Jdbailey7/NSSL_EFM_Rotating_PCB/Renders/pcb_back.png

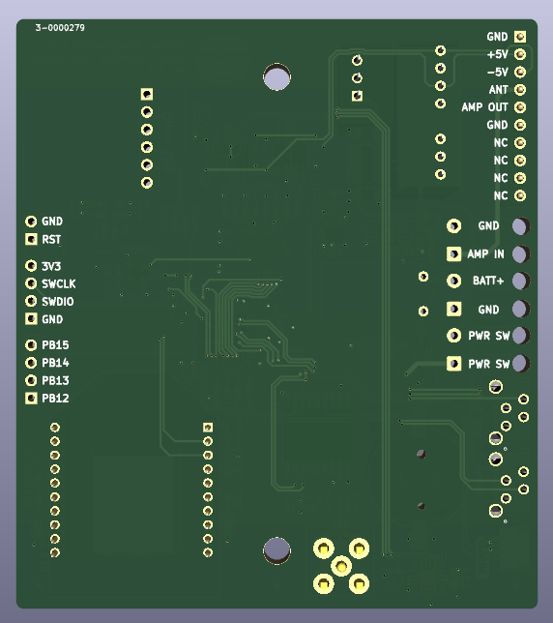
Renders/pcb_back.png
