Jdbailey7/NSSL_EFM_Rotating_PCB/Renders/pcb_front.png

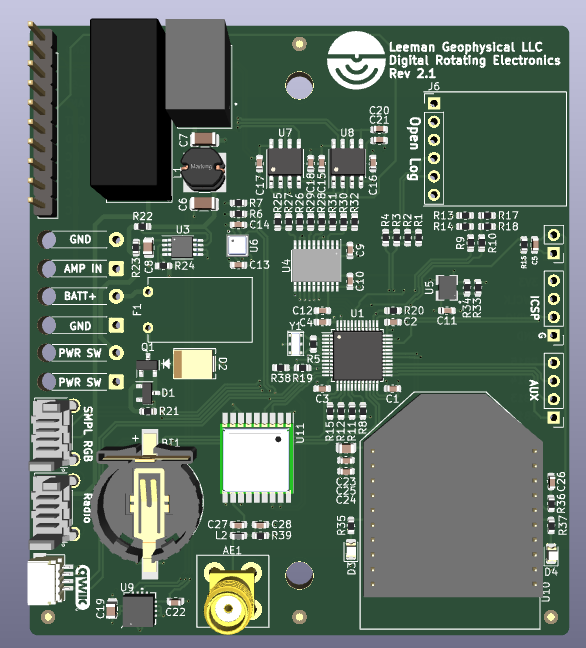
Renders/pcb_front.png
