Jdbailey7/NSSL_EFM_Rotating_PCB/PDFs/schematic.pdf

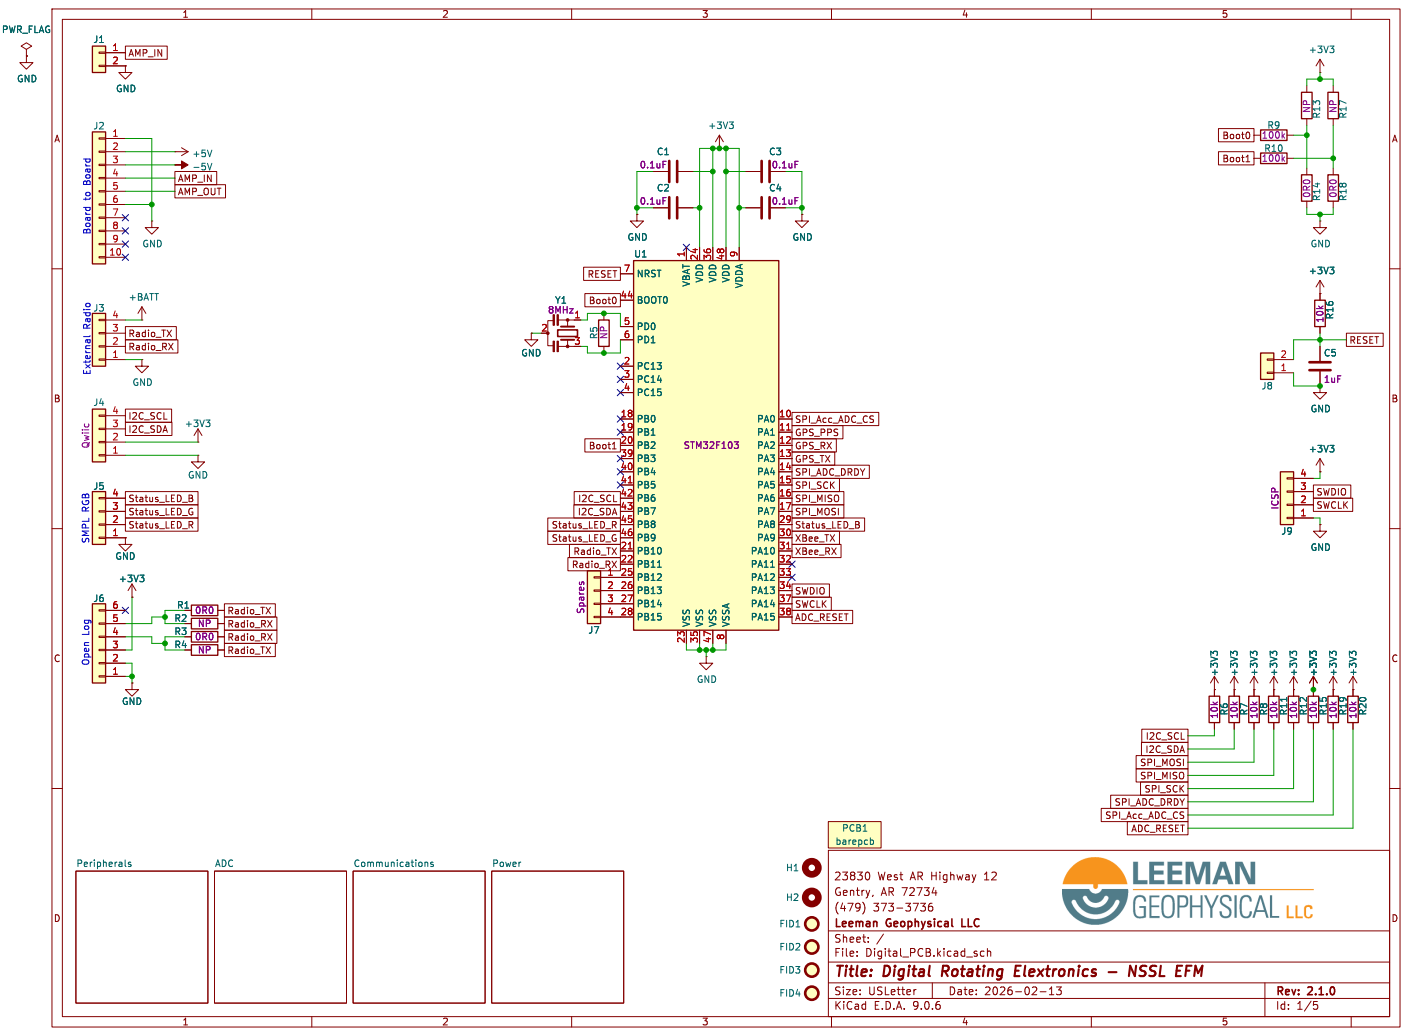
[picture p3: page 1]

1 VSS 23 VDD 24 VSS 35 VDD 36 VSS 47 VDD 48 VSSA

Id: 1/5 Title: Digital Rotating Elextronics - NSSL EFM

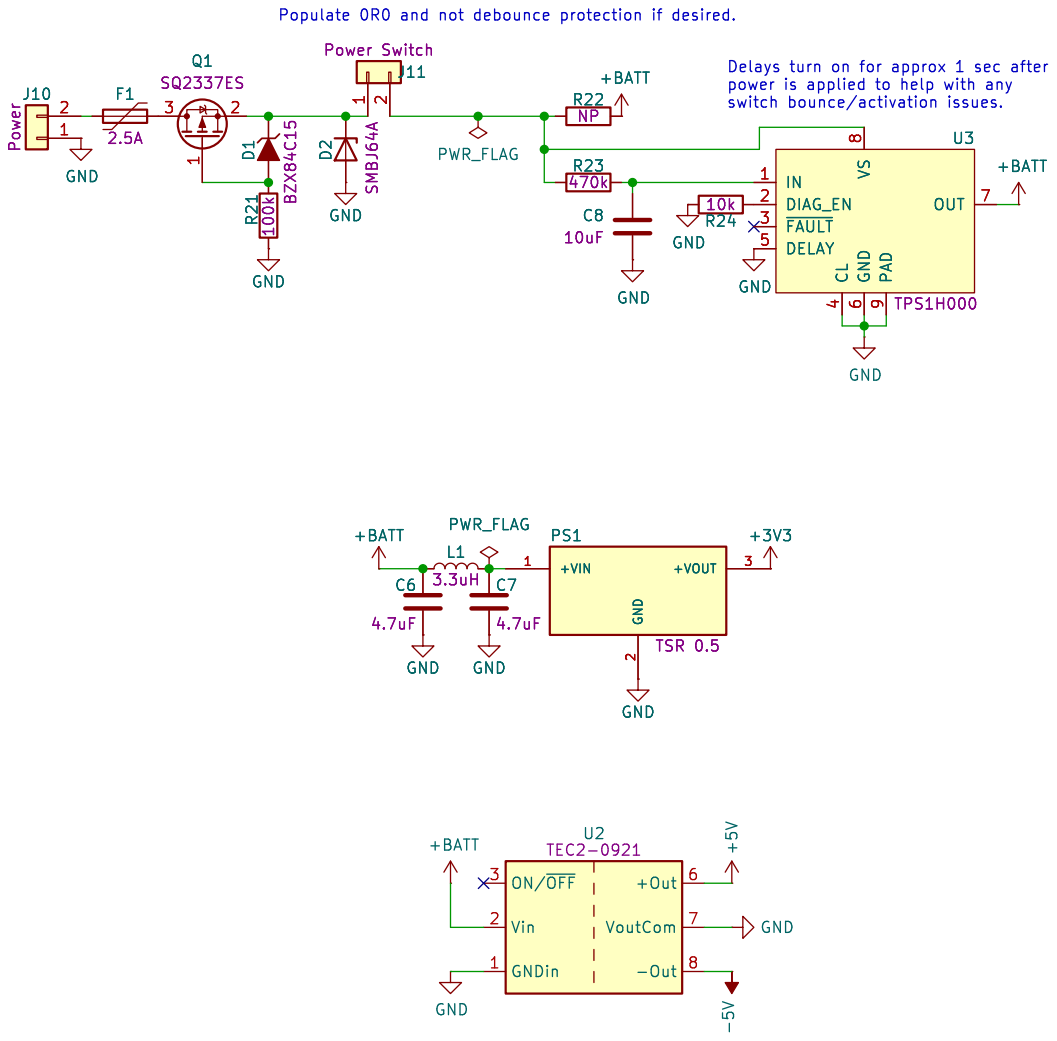
[picture p4: page 2]

9 OUT 7 U3 TPS1H000 Delays turn on for approx 1 sec after power is applied to help with any

2 +VIN 1 +VOUT 3 PS1 TSR 0.5 GND

9 OUT 7 +BATT GND GND

Id: 2/5 Title: Digital Rotating Elextronics - NSSL EFM

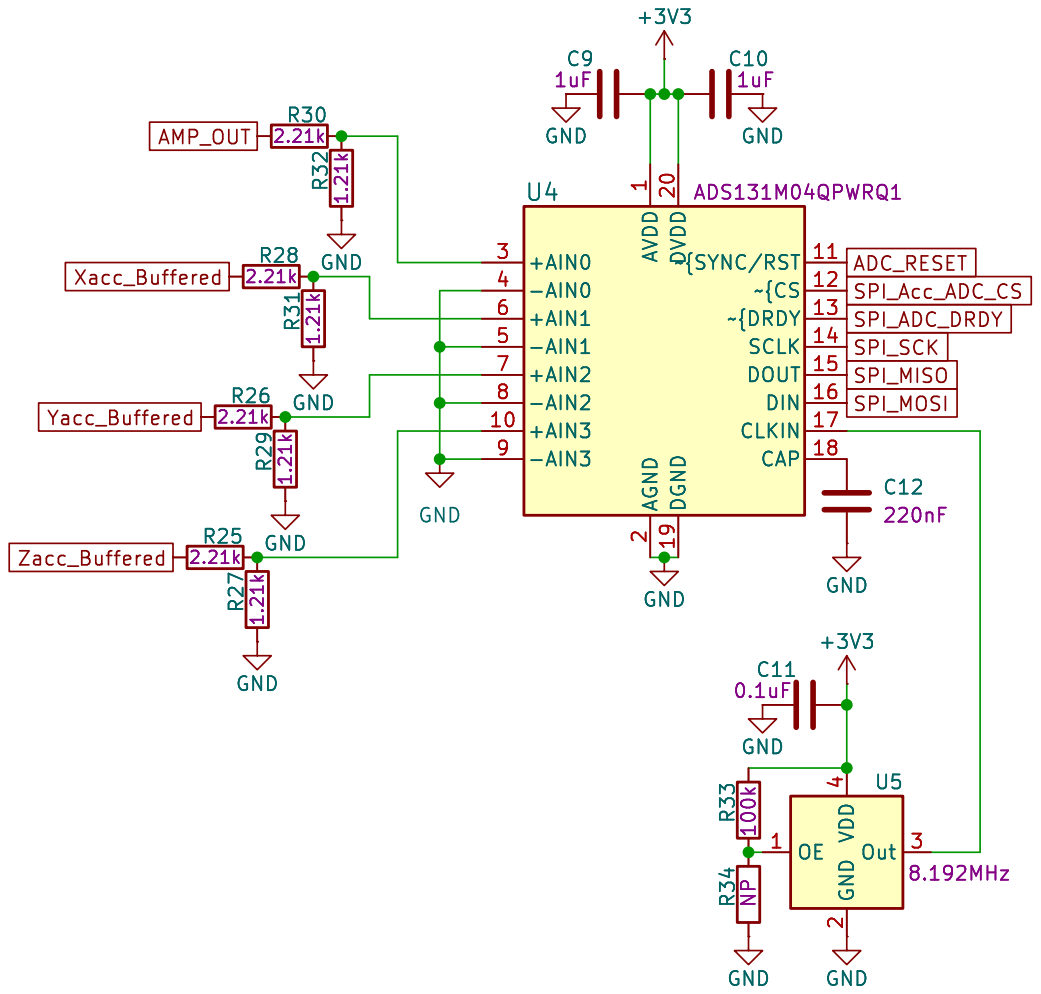
[picture p5: page 3]

Id: 3/5 Title: Digital Rotating Elextronics - NSSL EFM

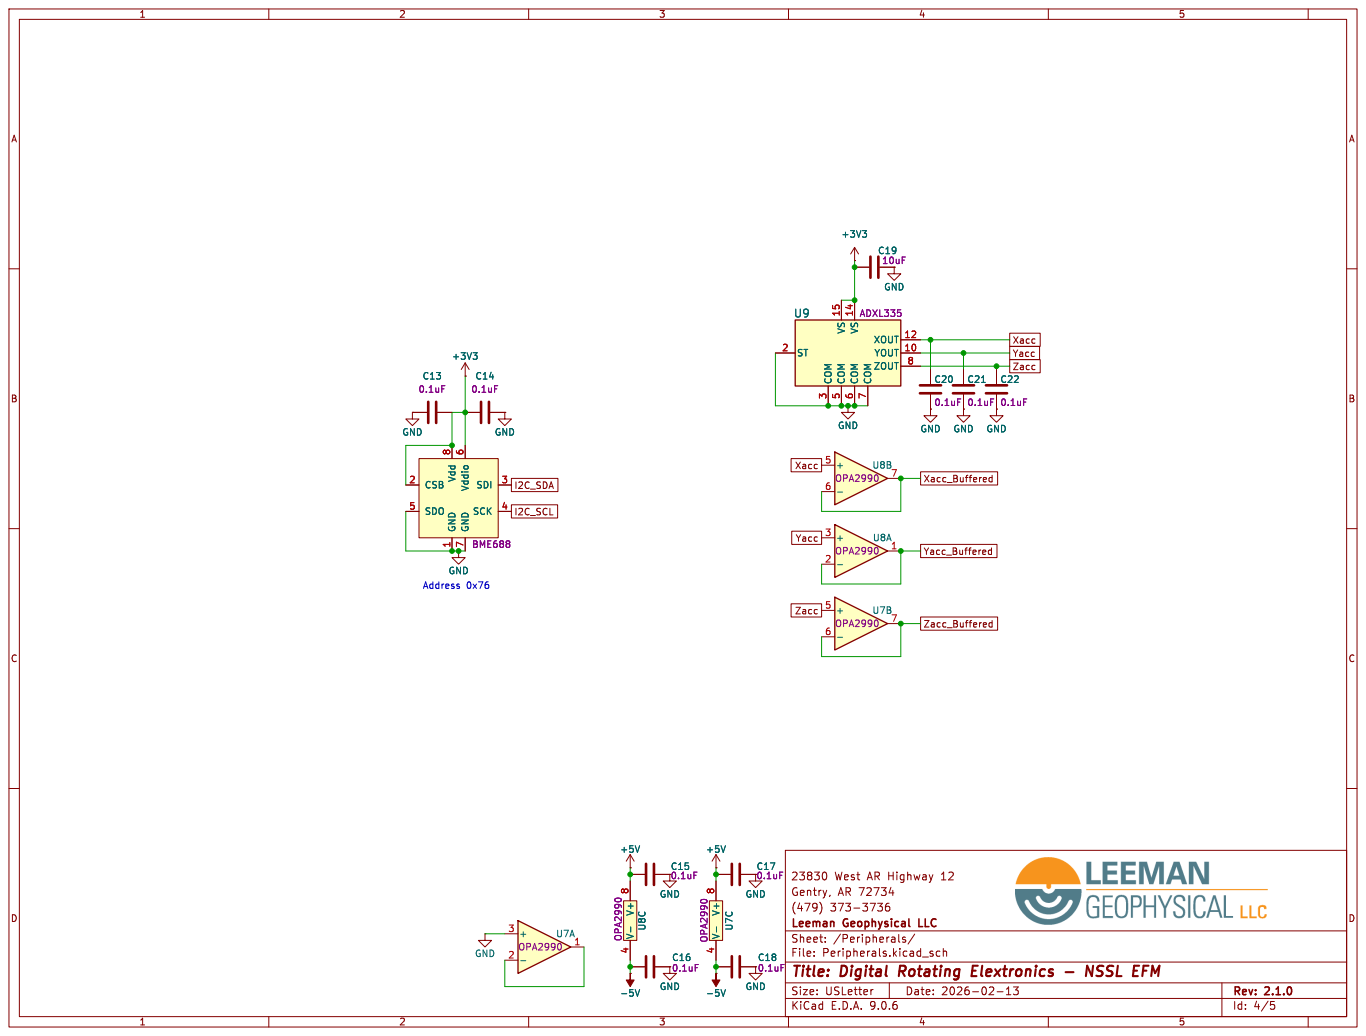
[picture p6: page 4]

(479) 373-3736 Gentry, AR 72734

E.D.A. 9.0.6 Size: USLetter | Rev: 2.1.0 | D Date: 2026-02-13 KiCad

Id: 4/5 Title: Digital Rotating Elextronics - NSSL EFM

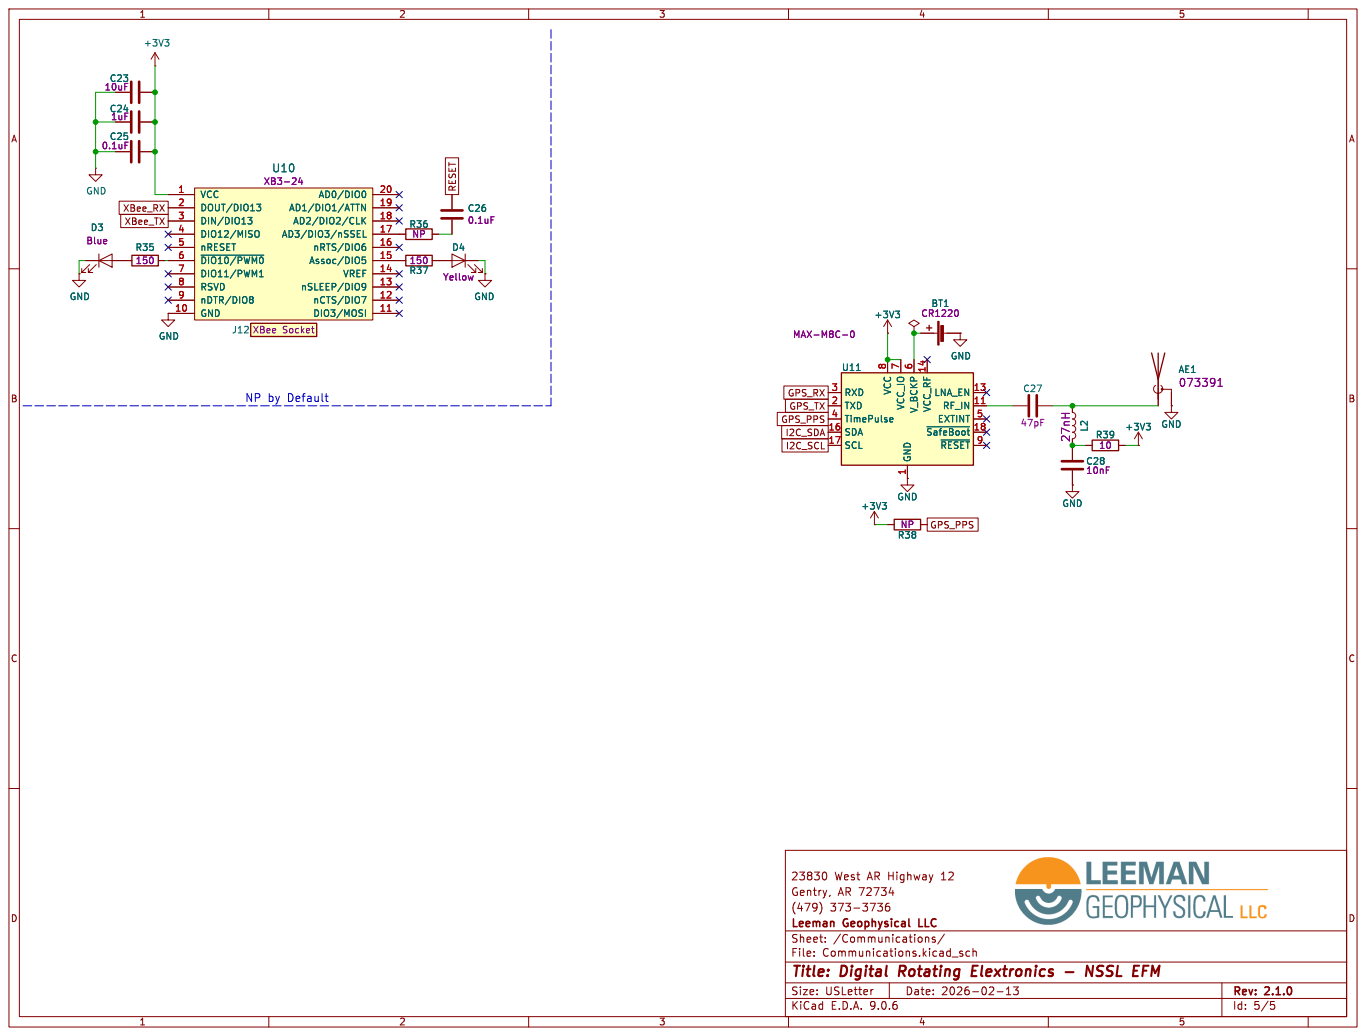
[picture p7: page 5]

Id: 5/5 Title: Digital Rotating Elextronics - NSSL EFM
