Jdbailey7/NSSL_EFM_Rotating_PCB/PDFs/pcb.pdf

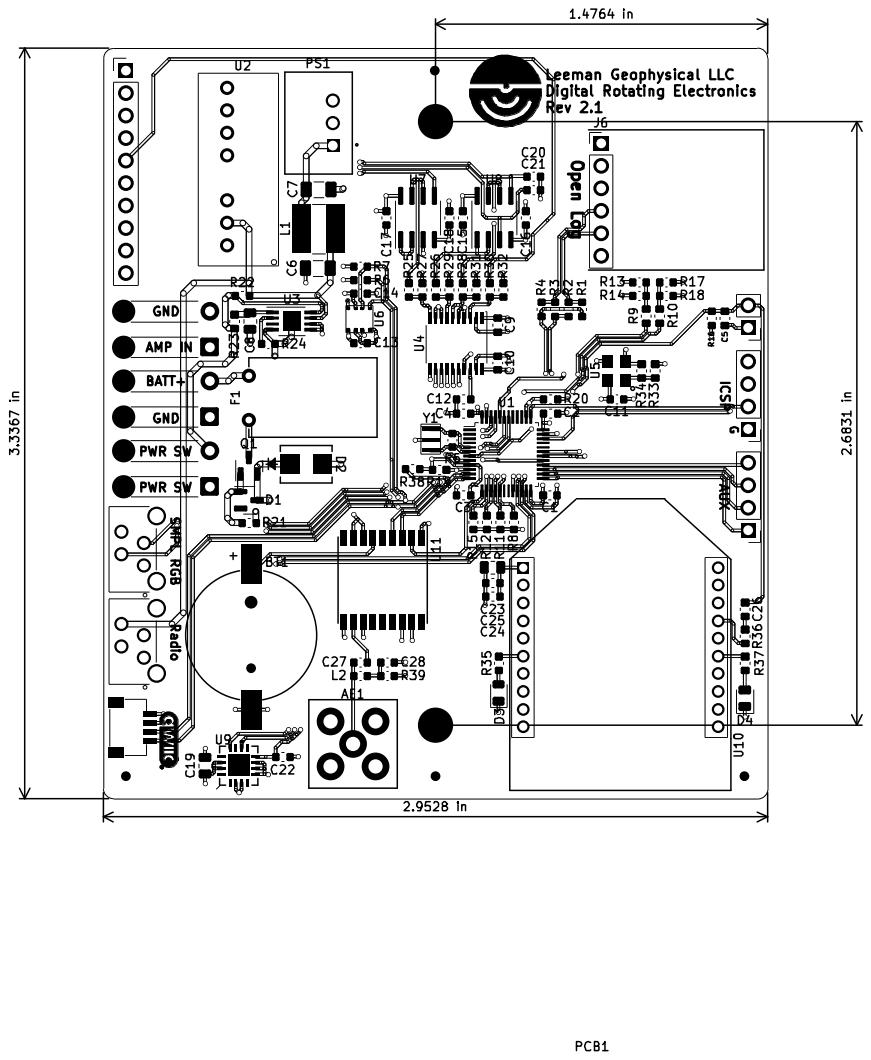
[picture p8: page 1]
