Jdbailey7/NSSL_EFM_Rotating_PCB/KiCAD_Project/Digital_PCB.kicad_pcb

## KiCad design KiCAD_Project/Digital_PCB.kicad_pcb (2026-02-13)

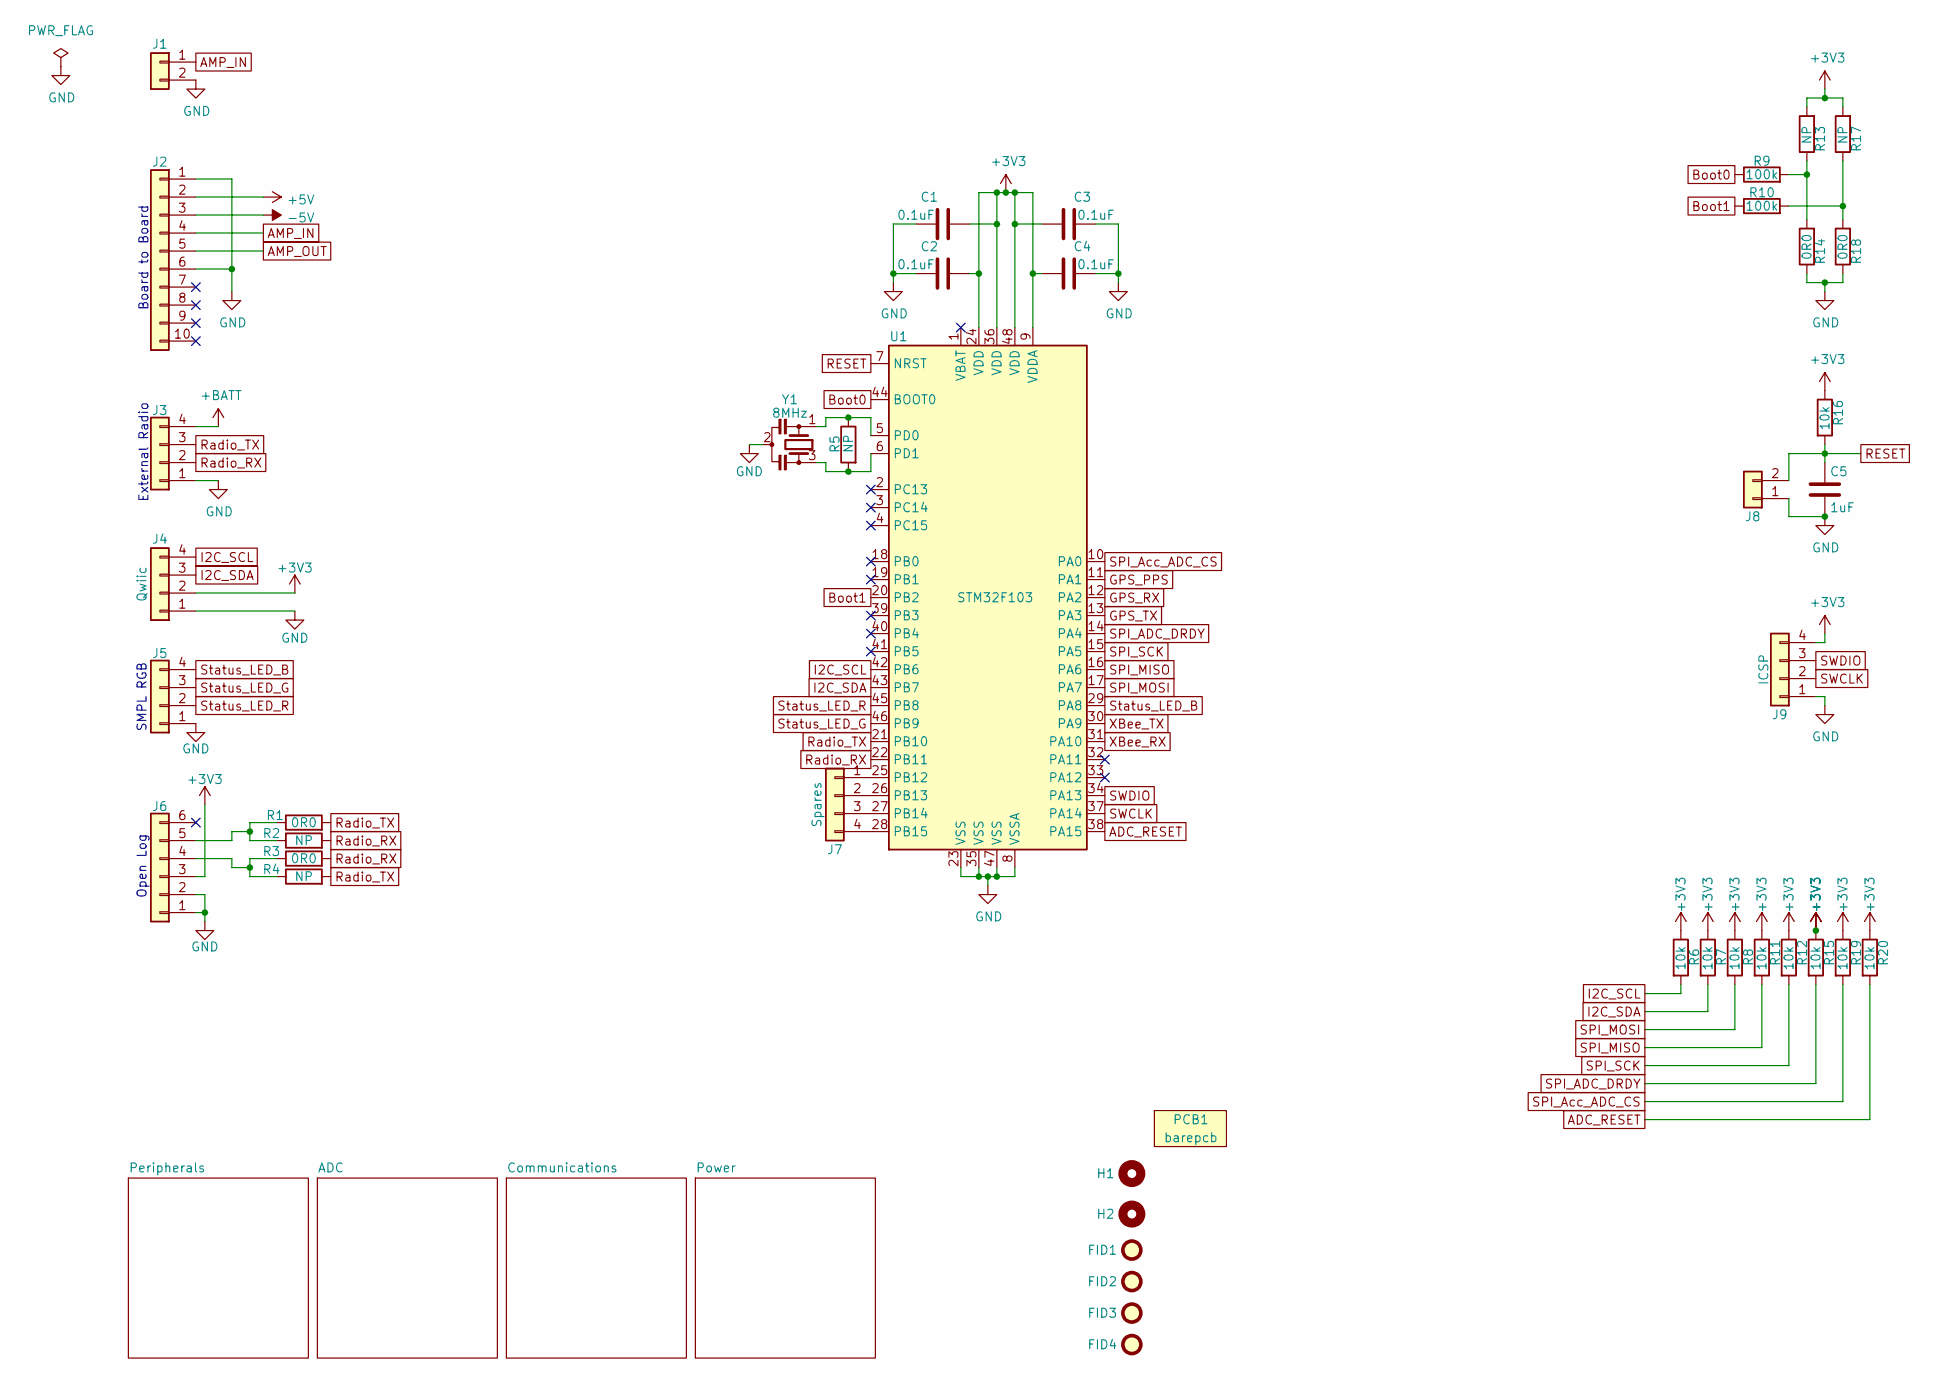
[picture p9: schematic Digital_PCB.kicad_sch, Digital Rotating Elextronics - NSSL EFM]

Parts:
C1, C2, C3, C4: 1-0000007
C5: 1-0000018
FID1, FID2, FID3, FID4: Fiducial_1mm_2mm; Fiducial_1mm_Mask2mm
H1, H2: Imperial6; MountingHole_imperial6
J1: NP_Conn_01x02_Relief; SolderWire_1x02_Relief
J2: Board to Board; PinHeader_1x10_P2.54mm_Vertical
J3, J5: 1-0001156
J4: 1-0001205
J6: NP_Conn_01x06; PinHeader_1x06_P2.54mm_Vertical
J7, J9: NP_Conn_01x04; PinHeader_1x04_P2.54mm_Vertical
J8: NP_Conn_01x02_Relief; PinHeader_1x02_P2.54mm_Vertical
PCB1: barepcb
R1, R2, R3, R4, R5, R13, R14, R17, R18: 1-0000006
R6, R7, R8, R11, R12, R15, R16, R19, R20: 1-0000010
R9, R10: 1-0000174
U1: 1-0000207
Y1: 1-0000721

Connections:
+3V3: C1.2, C2.2, C3.2, C4.2, J4.2, J6.3, J9.4, R6.1, R7.1, R8.1, R11.1, R12.1, R13.2, R15.1, R16.1, R17.2, R19.1, R20.1, U1.9 (VDDA), U1.24 (VDD), U1.36 (VDD), U1.48 (VDD); also elsewhere on the board
+5V: J2.2; also elsewhere on the board
+BATT: J3.4; also elsewhere on the board
-5V: J2.3; also elsewhere on the board
ADC_RESET: R20.2, U1.38 (PA15); also elsewhere on the board
AMP_IN: J1.1, J2.4
AMP_OUT: J2.5; also elsewhere on the board
Boot0: R9.1, U1.44 (BOOT0)
Boot1: R10.1, U1.20 (PB2)
GND: C1.1, C2.1, C3.1, C4.1, C5.2, J1.2, J2.1, J2.6, J3.1, J4.1, J5.1, J6.1, J6.2, J8.1, J9.1, R14.1, R18.1, U1.8 (VSSA), U1.23 (VSS), U1.35 (VSS), U1.47 (VSS), Y1.2; also elsewhere on the board
GPS_PPS: U1.11 (PA1); also elsewhere on the board
GPS_RX: U1.12 (PA2); also elsewhere on the board
GPS_TX: U1.13 (PA3); also elsewhere on the board
I2C_SCL: J4.4, R6.2, U1.42 (PB6); also elsewhere on the board
I2C_SDA: J4.3, R7.2, U1.43 (PB7); also elsewhere on the board
unnamed: J6.4, R3.1, R4.1
unnamed: J6.5, R1.1, R2.1
unnamed: J7.1, U1.25 (PB12)
unnamed: J7.2, U1.26 (PB13)
unnamed: J7.3, U1.27 (PB14)
unnamed: J7.4, U1.28 (PB15)
unnamed: R10.2, R17.1, R18.2
unnamed: R9.2, R13.1, R14.2
unnamed: R5.1, U1.5 (PD0), Y1.1
unnamed: R5.2, U1.6 (PD1), Y1.3
RESET: C5.1, J8.2, R16.2, U1.7 (NRST); also elsewhere on the board
Radio_RX: J3.2, R2.2, R3.2, U1.22 (PB11)
Radio_TX: J3.3, R1.2, R4.2, U1.21 (PB10)
SPI_ADC_DRDY: R15.2, U1.14 (PA4); also elsewhere on the board
SPI_Acc_ADC_CS: R19.2, U1.10 (PA0); also elsewhere on the board
SPI_MISO: R11.2, U1.16 (PA6); also elsewhere on the board
SPI_MOSI: R8.2, U1.17 (PA7); also elsewhere on the board
SPI_SCK: R12.2, U1.15 (PA5); also elsewhere on the board
SWCLK: J9.2, U1.37 (PA14)
SWDIO: J9.3, U1.34 (PA13)
Status_LED_B: J5.4, U1.29 (PA8)
Status_LED_G: J5.3, U1.46 (PB9)
Status_LED_R: J5.2, U1.45 (PB8)
XBee_RX: U1.31 (PA10); also elsewhere on the board
XBee_TX: U1.30 (PA9); also elsewhere on the board

Notes on the sheet:
Board to Board
External Radio
Open Log
SMPL RGB

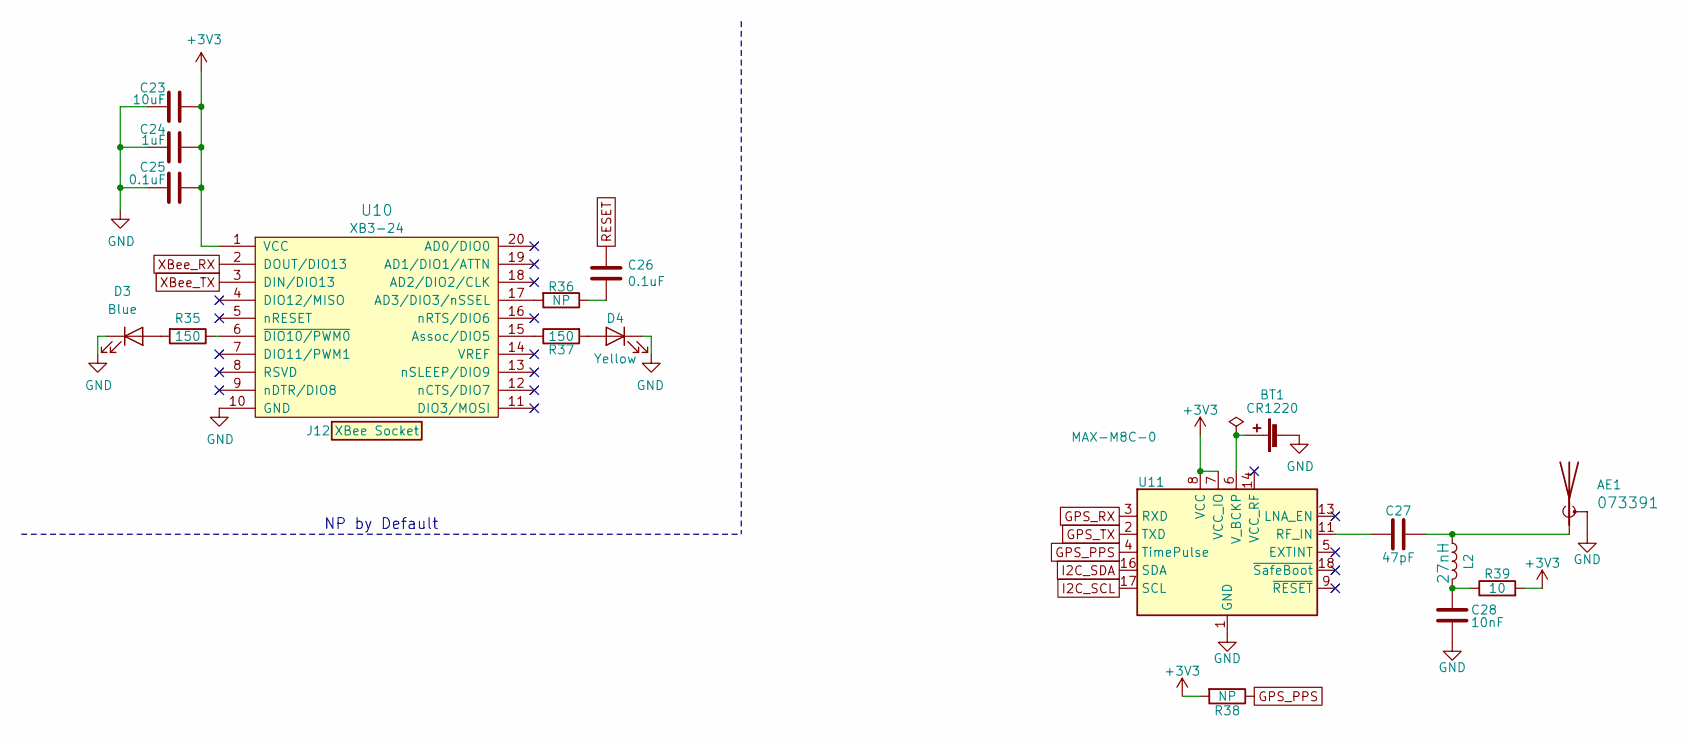
[picture p10: schematic Communications.kicad_sch, Digital Rotating Elextronics - NSSL EFM]

Parts:
AE1: 1-0000461
BT1: 1-0000246
C23: 1-0000075
C24: 1-0000018
C25, C26: 1-0000007
C27: 1-0000458
C28: 1-0000014
D3: 1-0000599
D4: 1-0000601
J12: 1-0000050
L2: 1-0000459
R35, R37: 1-0000008
R36: 1-0000006
R38: 1-0000010
R39: 1-0000678
U10: 1-0000785
U11: 1-0000464

Connections:
+3V3: C23.1, C24.1, C25.1, R38.2, R39.2, U10.1 (VCC), U11.7 (VCC_IO), U11.8 (VCC); also elsewhere on the board
GND: AE1.2 (Shield), BT1.2 (-), C23.2, C24.2, C25.2, C28.2, D3.1 (K), D4.1 (K), U10.10 (GND), U11.1 (GND), U11.10 (GND), U11.12 (GND); also elsewhere on the board
GPS_PPS: R38.1, U11.4 (TimePulse); also elsewhere on the board
GPS_RX: U11.3 (RXD); also elsewhere on the board
GPS_TX: U11.2 (TXD); also elsewhere on the board
I2C_SCL: U11.17 (SCL); also elsewhere on the board
I2C_SDA: U11.16 (SDA); also elsewhere on the board
unnamed: AE1.1 (A), C27.2, L2.1
unnamed: BT1.1 (+), U11.6 (V_BCKP)
unnamed: C26.2, R36.1
unnamed: C28.1, L2.2, R39.1
unnamed: D3.2 (A), R35.2
unnamed: D4.2 (A), R37.2
unnamed: R36.2, U10.17 (AD3/DIO3/nSSEL)
unnamed: R37.1, U10.15 (Assoc/DIO5)
unnamed: R35.1, U10.6 (~DIO10/PWM0)
unnamed: C27.1, U11.11 (RF_IN)
RESET: C26.1; also elsewhere on the board
XBee_RX: U10.2 (DOUT/DIO13); also elsewhere on the board
XBee_TX: U10.3 (DIN/DIO13); also elsewhere on the board

Notes on the sheet:
NP by Default

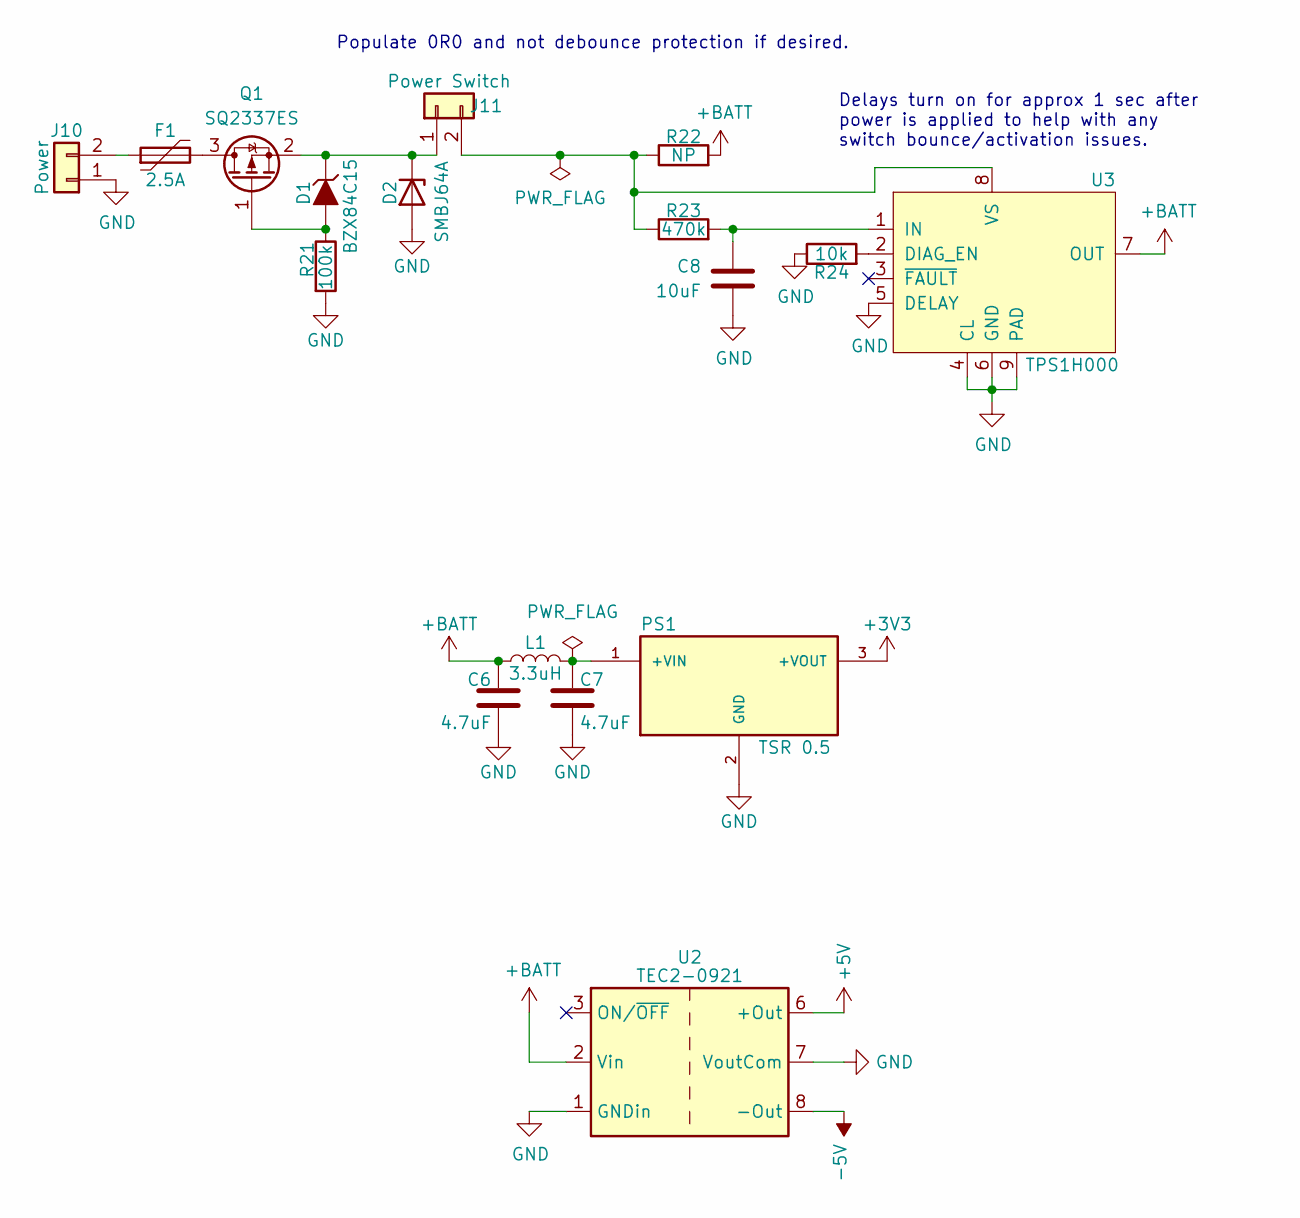
[picture p11: schematic Power.kicad_sch, Digital Rotating Elextronics - NSSL EFM]

Parts:
C6, C7: 1-0000136
C8: 1-0000075
D1: 1-0001672
D2: 1-0001537
F1: 1-0000269
J10, J11: NP_Conn_01x02_Relief; SolderWire_1x02_Relief
L1: 1-0000931
PS1: 1-0000727
Q1: 1-0001670
R21: 1-0000174
R22: 1-0000006
R23: 1-0000068
R24: 1-0000010
U2: 1-0000465
U3: 1-0000576

Connections:
+3V3: PS1.3 (+VOUT); also elsewhere on the board
+5V: U2.6 (+Out); also elsewhere on the board
+BATT: C6.1, L1.1, R22.2, U2.2 (Vin), U3.7 (OUT); also elsewhere on the board
-5V: U2.8 (-Out); also elsewhere on the board
GND: C6.2, C7.2, C8.1, D2.2 (A), J10.1, PS1.2 (GND), R21.2, R24.1, U2.1 (GNDin), U2.7 (VoutCom), U3.4 (CL), U3.5 (DELAY), U3.6 (GND), U3.9 (PAD); also elsewhere on the board
unnamed: D1.1 (A), Q1.1 (G), R21.1
unnamed: D1.3 (K), D2.1 (K), J11.1, Q1.2 (S)
unnamed: F1.1, J10.2
unnamed: J11.2, R22.1, R23.1, U3.8 (VS)
unnamed: C7.1, L1.2, PS1.1 (+VIN)
unnamed: F1.2, Q1.3 (D)
unnamed: R24.2, U3.2 (DIAG_EN)
unnamed: C8.2, R23.2, U3.1 (IN)

Notes on the sheet:
Populate 0R0 and not debounce protection if desired.
Delays turn on for approx 1 sec after power is applied to help with any switch bounce/activation issues.

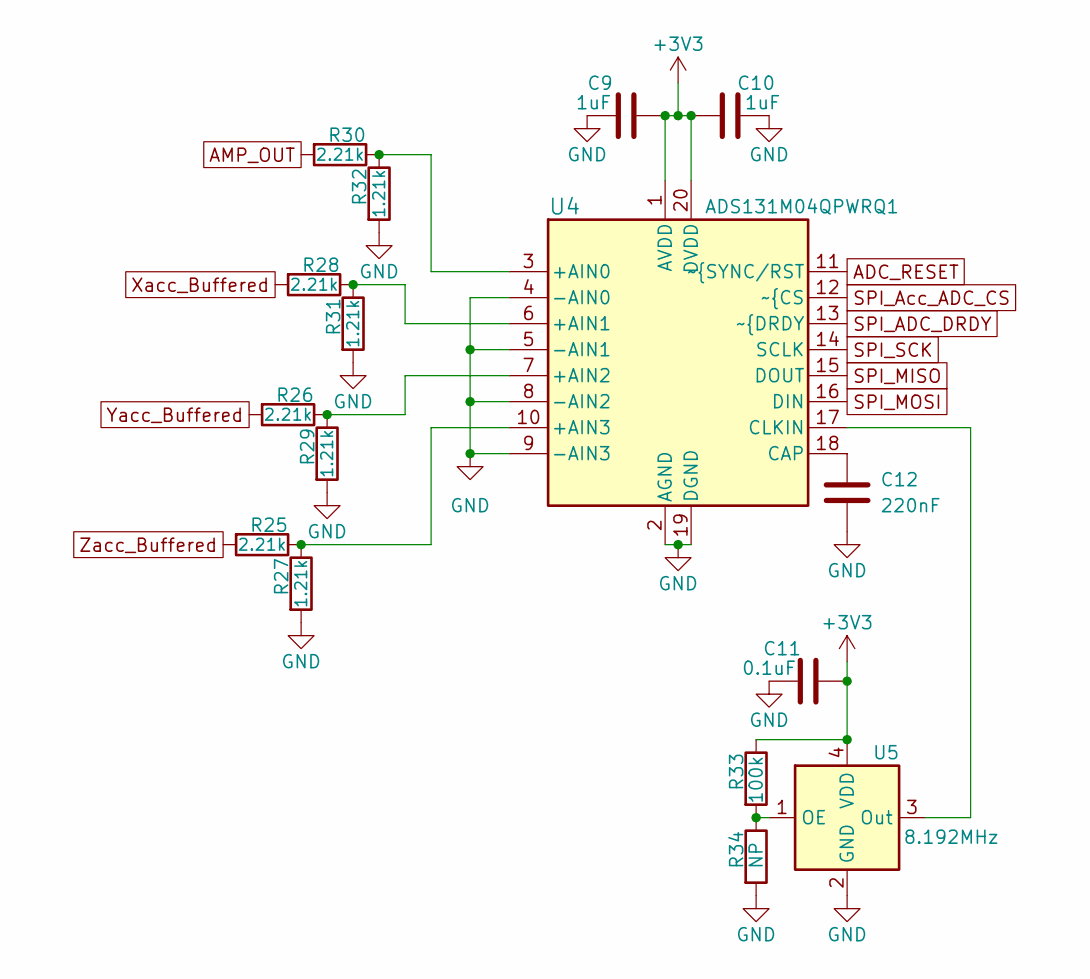
[picture p12: schematic ADC.kicad_sch, Digital Rotating Elextronics - NSSL EFM]

Parts:
C9, C10: 1-0000018
C11: 1-0000007
C12: 1-0000926
R25, R26, R28, R30: 1-0001551
R27, R29, R31, R32: 1-0001553
R33: 1-0000174
R34: 1-0000006
U4: 1-0001530
U5: 1-0001542

Connections:
+3V3: C9.1, C10.1, C11.2, R33.1, U4.1 (AVDD), U4.20 (DVDD), U5.4 (VDD); also elsewhere on the board
ADC_RESET: U4.11 (~{SYNC/RST); also elsewhere on the board
AMP_OUT: R30.2; also elsewhere on the board
GND: C9.2, C10.2, C11.1, C12.2, R27.2, R29.2, R31.2, R32.2, R34.2, U4.2 (AGND), U4.4 (-AIN0), U4.5 (-AIN1), U4.8 (-AIN2), U4.9 (-AIN3), U4.19 (DGND), U5.2 (GND); also elsewhere on the board
unnamed: R30.1, R32.1, U4.3 (+AIN0)
unnamed: R28.1, R31.1, U4.6 (+AIN1)
unnamed: R26.1, R29.1, U4.7 (+AIN2)
unnamed: R25.1, R27.1, U4.10 (+AIN3)
unnamed: C12.1, U4.18 (CAP)
unnamed: U4.17 (CLKIN), U5.3 (Out)
unnamed: R33.2, R34.1, U5.1 (OE)
SPI_ADC_DRDY: U4.13 (~{DRDY); also elsewhere on the board
SPI_Acc_ADC_CS: U4.12 (~{CS); also elsewhere on the board
SPI_MISO: U4.15 (DOUT); also elsewhere on the board
SPI_MOSI: U4.16 (DIN); also elsewhere on the board
SPI_SCK: U4.14 (SCLK); also elsewhere on the board
Xacc_Buffered: R28.2; also elsewhere on the board
Yacc_Buffered: R26.2; also elsewhere on the board
Zacc_Buffered: R25.2; also elsewhere on the board

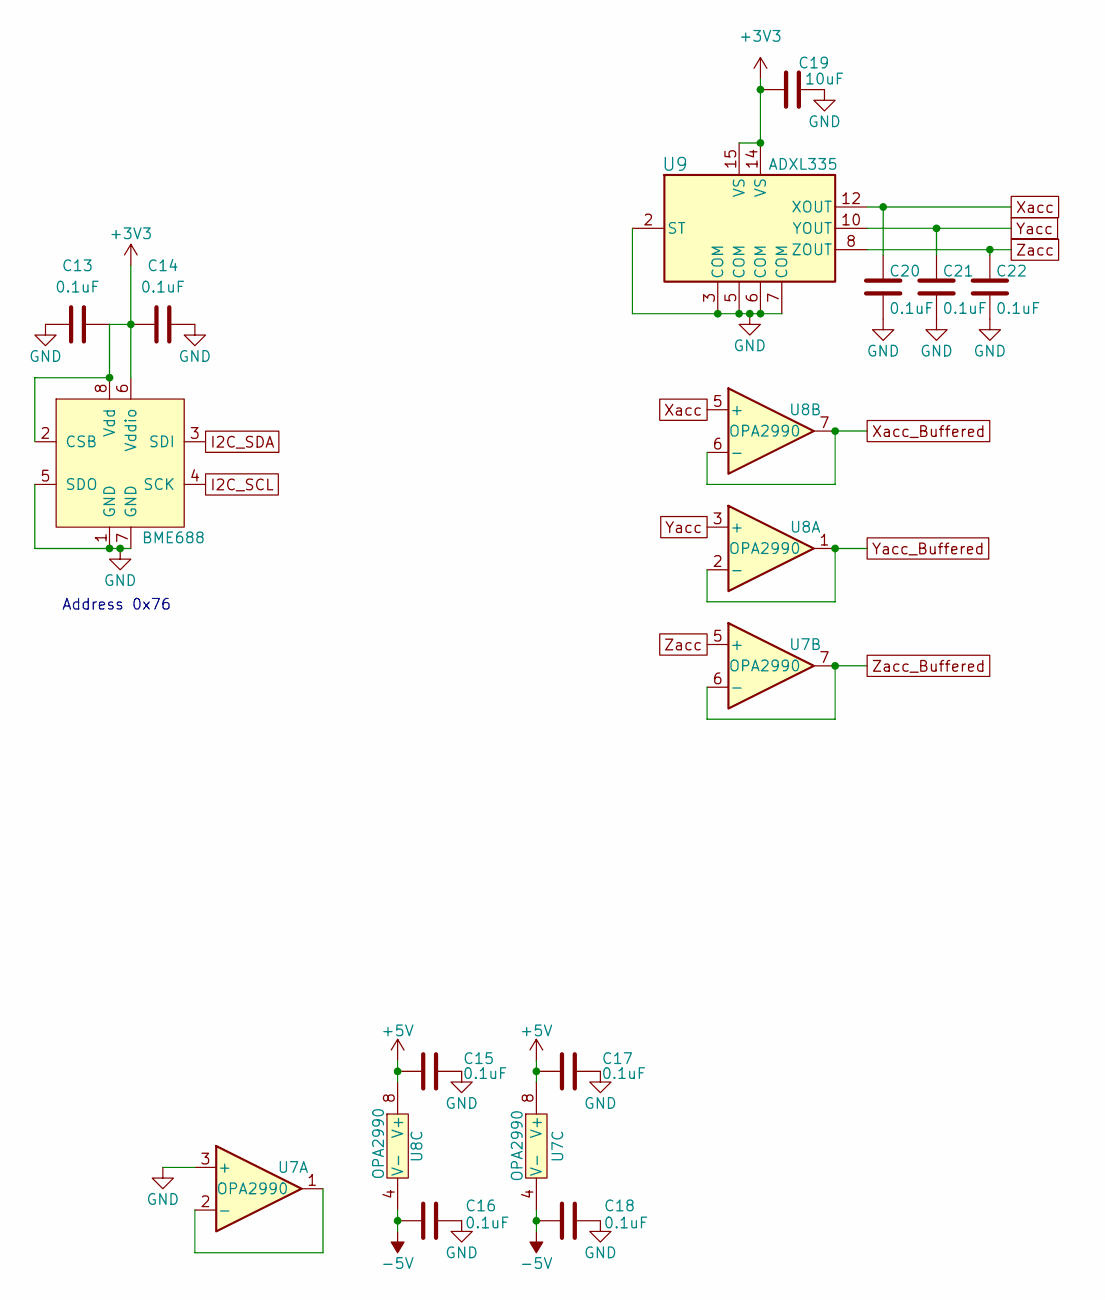
[picture p13: schematic Peripherals.kicad_sch, Digital Rotating Elextronics - NSSL EFM]

Parts:
C13, C14, C15, C16, C17, C18, C20, C21, C22: 1-0000007
C19: 1-0000075
U6: 1-0001471
U7, U8: 1-0000264
U9: 1-0001535

Connections:
+3V3: C13.2, C14.1, C19.1, U6.2 (CSB), U6.6 (Vddio), U6.8 (Vdd), U9.14 (VS), U9.15 (VS); also elsewhere on the board
+5V: C15.1, C17.1, U7.8 (V+), U8.8 (V+); also elsewhere on the board
-5V: C16.1, C18.1, U7.4 (V-), U8.4 (V-); also elsewhere on the board
GND: C13.1, C14.2, C15.2, C16.2, C17.2, C18.2, C19.2, C20.2, C21.2, C22.2, U6.1 (GND), U6.5 (SDO), U6.7 (GND), U7.3 (+), U9.2 (ST), U9.3 (COM), U9.5 (COM), U9.6 (COM), U9.7 (COM); also elsewhere on the board
I2C_SCL: U6.4 (SCK); also elsewhere on the board
I2C_SDA: U6.3 (SDI); also elsewhere on the board
unnamed: U7.1, U7.2 (-)
Xacc: C20.1, U8.5 (+), U9.12 (XOUT)
Xacc_Buffered: U8.6 (-), U8.7; also elsewhere on the board
Yacc: C21.1, U8.3 (+), U9.10 (YOUT)
Yacc_Buffered: U8.1, U8.2 (-); also elsewhere on the board
Zacc: C22.1, U7.5 (+), U9.8 (ZOUT)
Zacc_Buffered: U7.6 (-), U7.7; also elsewhere on the board

Notes on the sheet:
Address 0x76

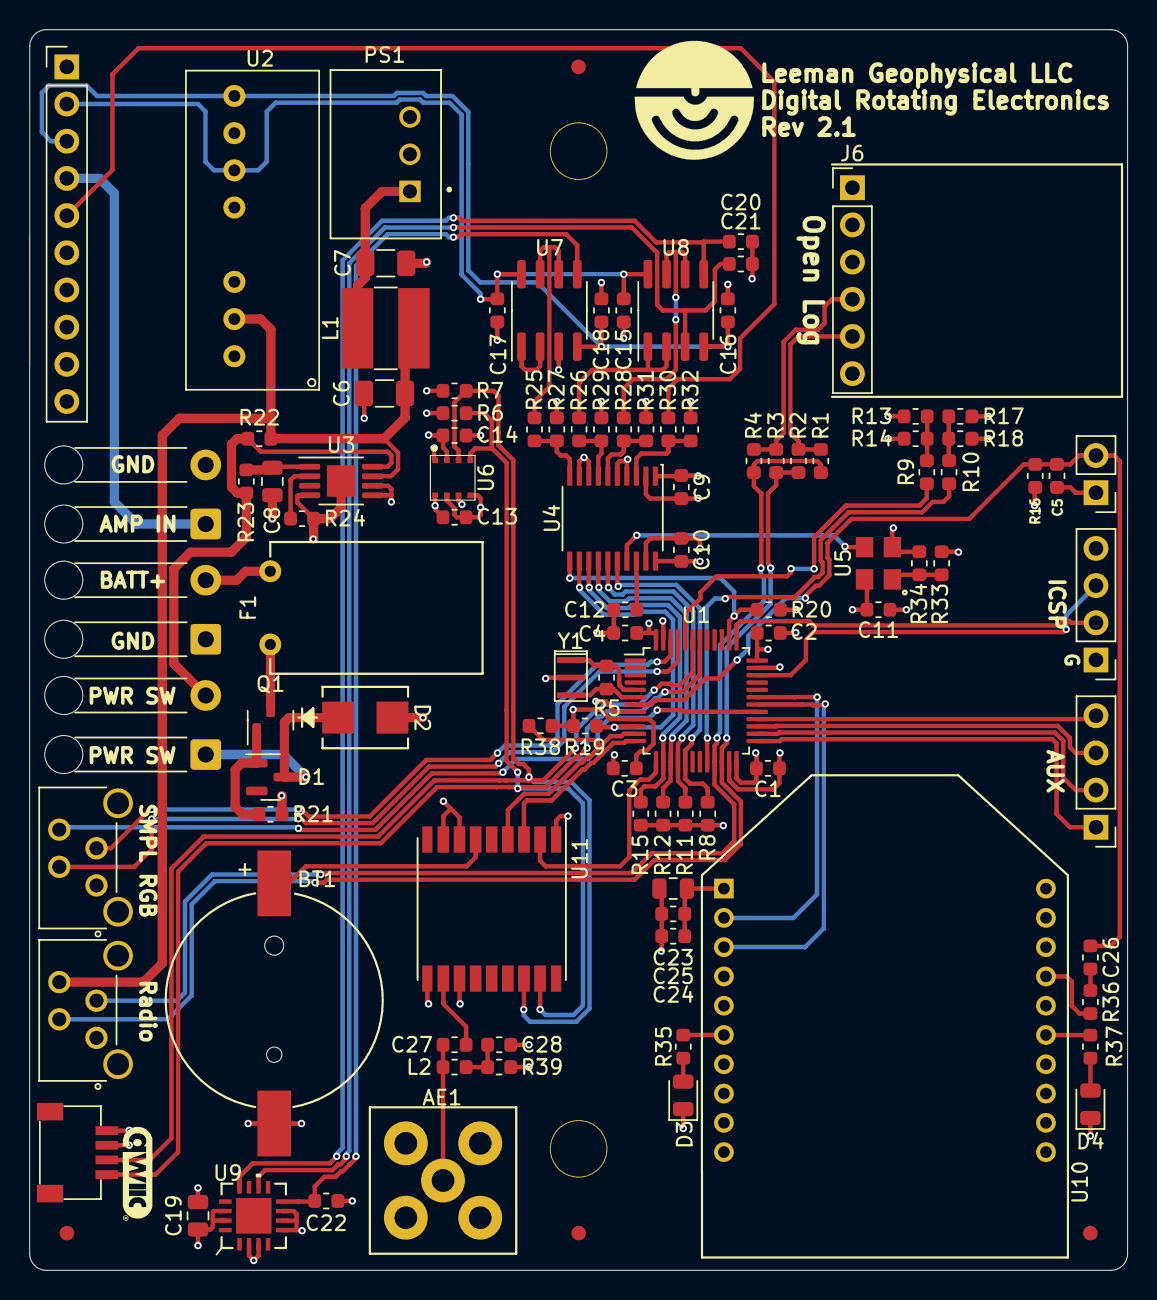
[picture p14: board Digital_PCB.kicad_pcb from above]

Board: 4 copper layers, 75.0 x 84.8 mm, 109 parts (0 on the bottom side), 72 nets.
