Jdbailey7/NSSL_EFM_Rotating_PCB/(commit log)

2025-09-12 Rev 2.1 Changes: - Fixed Issue #11 (U4 Footprint pin 1 indicator) - Added Open Log Header for breakout - Removed SD Circuit - Connected GPS to I2C - Updated IPN and Revision Number
    [ADC.kicad_sch, Communications.kicad_sch, Digital_PCB.kicad_pcb, Digital_PCB.kicad_sch, Peripherals.kicad_sch, Power.kicad_sch]
2026-02-13 Make Rev 2.1 production files
    [ADC.kicad_sch, Communications.kicad_sch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]
